StuyCEC/jimbo-0/images/20230901_005157.webp

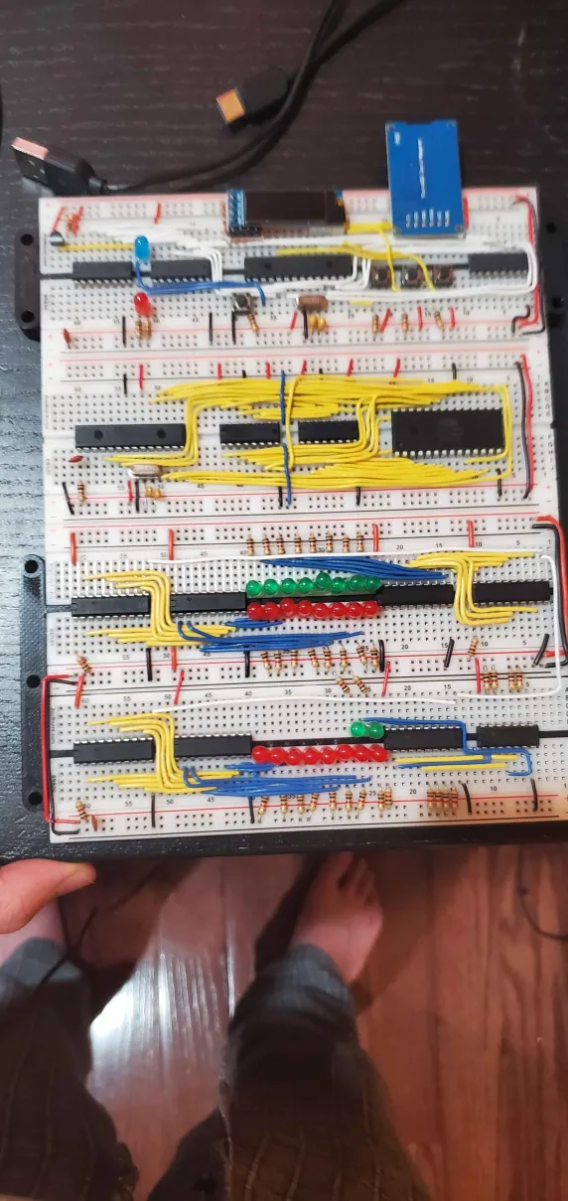
images/20230901_005157.webp
