StuyCEC/jimbo-0/images/20230902_104515.webp

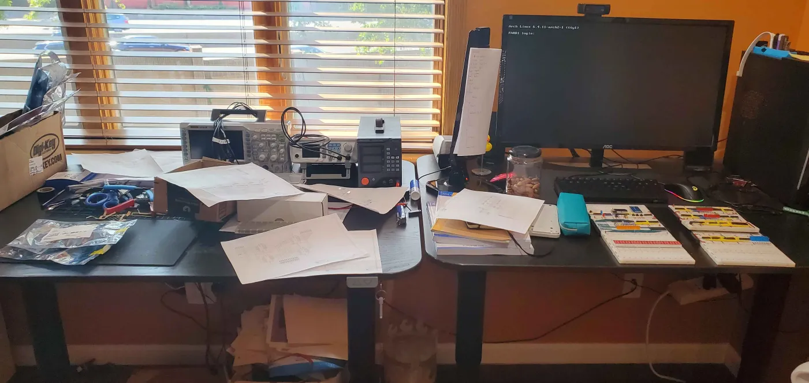
images/20230902_104515.webp
