StuyCEC/jimbo-0/images/20230902_191515.webp

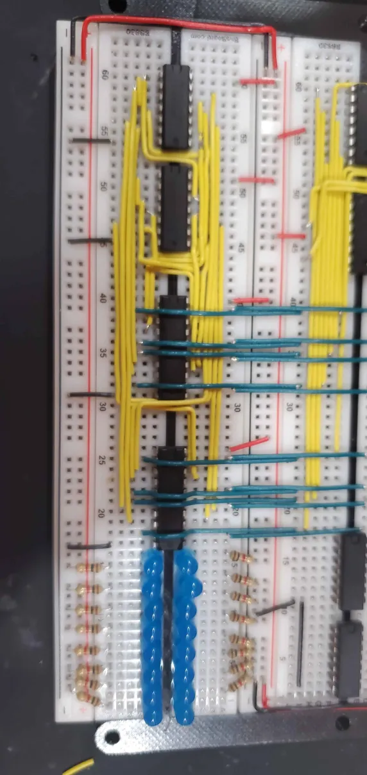
images/20230902_191515.webp
