StuyCEC/jimbo-0/labels/ROM_LABELS.png

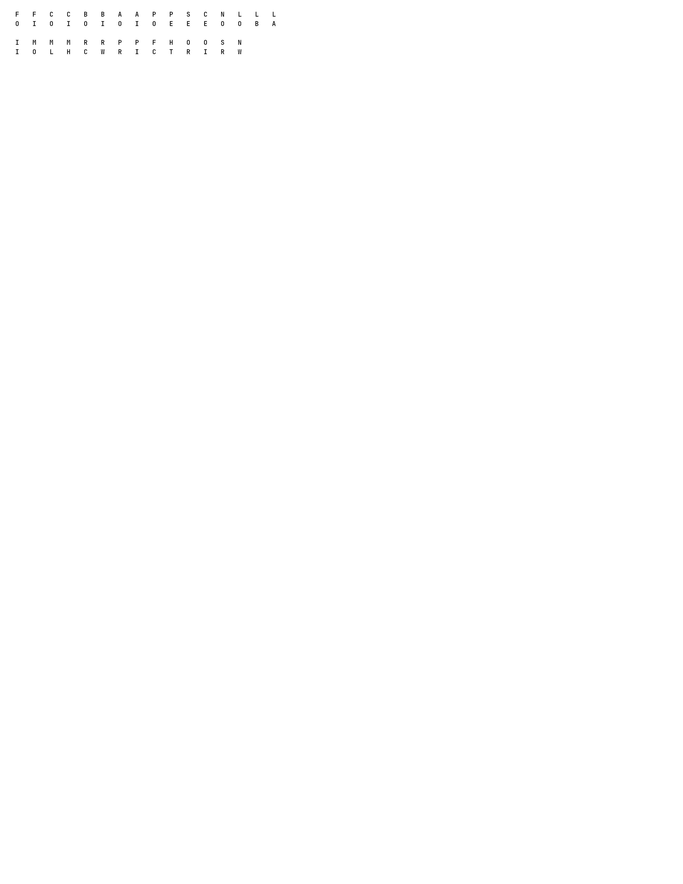
labels/ROM_LABELS.png
