StuyCEC/jimbo-0/schematics/schematics.kicad_pcb

## KiCad design morse_kicad_files/morse_transceiver.kicad_sch

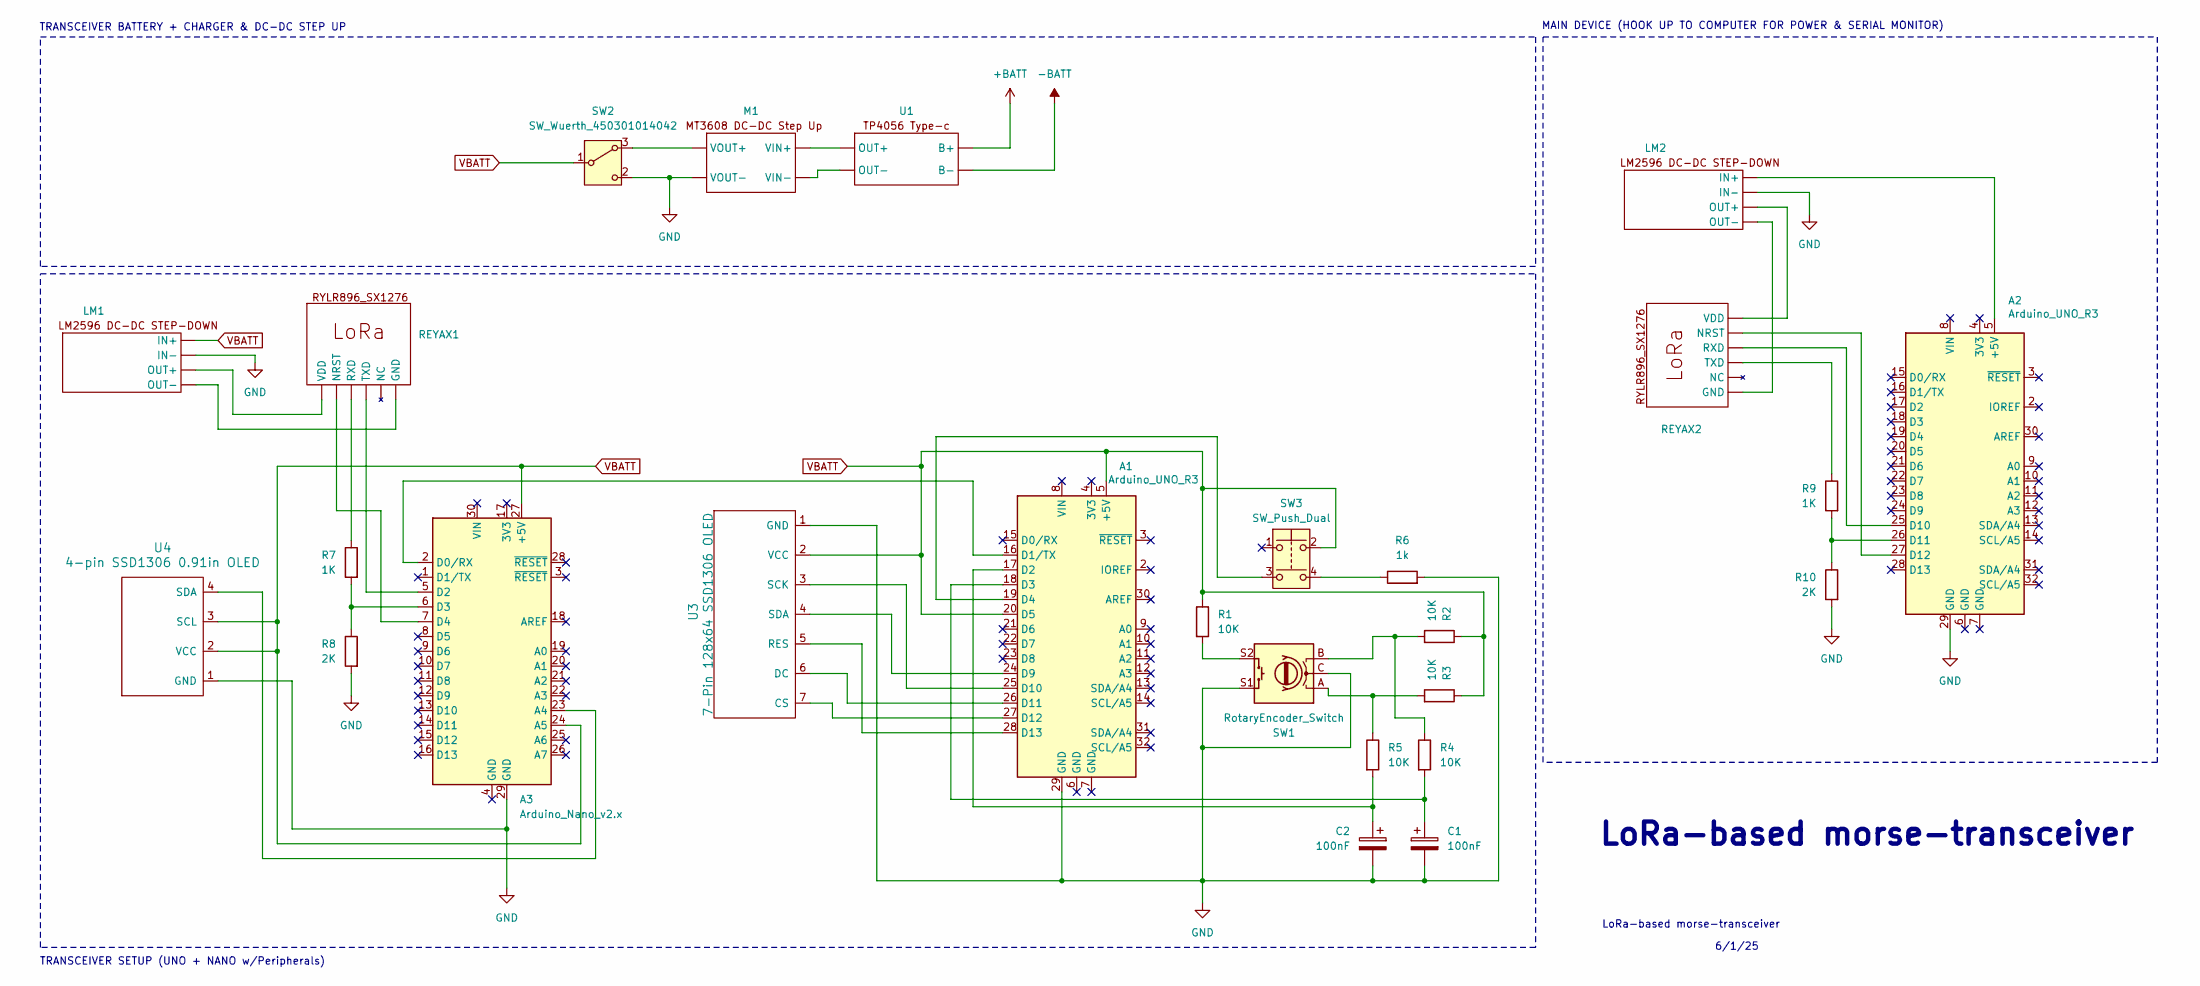
[picture p15: schematic morse_transceiver.kicad_sch]

Parts:
A1, A2: Arduino_UNO_R3
A3: Arduino_Nano_v2.x; Arduino_Nano
C1, C2: 100nF
LM1, LM2: (no value)
M1: (no value)
R1, R2, R3, R4, R5: 10K
R6: 1k
R7, R9: 1K
R8, R10: 2K
REYAX1, REYAX2: (no value)
SW1: RotaryEncoder_Switch
SW2: SW_Wuerth_450301014042; SW_Slide-03_Wuerth-WS-SLTV_10x2.5x6.4_P2.54mm
SW3: SW_Push_Dual
U1: (no value)
U3: 7-Pin 128x64 SSD1306 OLED
U4: 4-pin SSD1306 0.91in OLED

Connections:
+BATT: U1.
-BATT: U1.
GND: A1.29 (GND), A2.29 (GND), A3.29 (GND), C1.2, C2.2, LM1., LM2., M1., R6.2, R8.2, R10.2, SW1.C, SW1.S1, SW2.2 (C), U3.1 (GND), U4.1 (GND)
unnamed: A1.16 (D1/TX), A3.2 (D0/RX)
unnamed: A1.17 (D2), C2.1, R5.2
unnamed: A1.18 (D3), C1.1, R4.2
unnamed: A1.19 (D4), SW3.3
unnamed: A1.24 (D9), U3.4 (SDA)
unnamed: A1.25 (D10), U3.3 (SCK)
unnamed: A1.26 (D11), U3.6 (DC)
unnamed: A1.27 (D12), U3.7 (CS)
unnamed: A1.28 (D13), U3.5 (RES)
unnamed: A2.5 (+5V), LM2.
unnamed: A2.25 (D10), REYAX2.
unnamed: A2.26 (D11), R9.2, R10.1
unnamed: A2.27 (D12), REYAX2.
unnamed: A3.5 (D2), REYAX1.
unnamed: A3.6 (D3), R7.2, R8.1
unnamed: A3.7 (D4), REYAX1.
unnamed: A3.23 (A4), U4.4 (SDA)
unnamed: LM1., REYAX1.
unnamed: LM2., REYAX2.
unnamed: M1., SW2.3 (A), U1.
unnamed: R1.2, SW1.S2
unnamed: R2.2, R4.1, SW1.B
unnamed: R3.2, R5.1, SW1.A
unnamed: R6.1, SW3.4
unnamed: R7.1, REYAX1.
unnamed: R9.1, REYAX2.
VBATT: A1.5 (+5V), A1.20 (D5), A3.24 (A5), A3.27 (+5V), LM1., R1.1, R2.1, R3.1, SW2.1 (B), SW3.2, U3.2 (VCC), U4.2 (VCC), U4.3 (SCL)

Notes on the sheet:
LoRa-based morse-transceiver
TRANSCEIVER SETUP (UNO + NANO w/Peripherals)
MAIN DEVICE (HOOK UP TO COMPUTER FOR POWER & SERIAL MONITOR)
TRANSCEIVER BATTERY + CHARGER & DC-DC STEP UP
6/1/25
