StuyCEC/jimbo-0/arduino-sketches/clock-module/config.h

 //Micro SD
#define SD_CS PB2

//CLOCK PIN
#define CLOCK PD0
#define HLT PD2

//Shift register pins
#define SER PD3
#define SRCLK PD4
#define SRCLR PD5
#define A_RCLK PD6
#define D_RCLK PD1
#define OE PD7

//RAM PINS
#define RAM_WE PC3
#define RAM_CE PC2
#define ROM_OE PC0

//OLED
#define OLED_RESET -1
#define I2C_ADDRESS 0x3C

//INPUT
#define BT1 PB0
#define BT2 PB1
#define BT3 PC1
#define debounceTimeOut 100

//SD CARD
#define SD_CS PB2
