StuyCEC/jimbo-0/arduino-sketches/output-register/config.h

//pins 
//D0 - D7
const byte BUS_PINS[8] = {PB1, PC5, PD0, PD1, PD2, PD5, PD6, PD7};
#define SER PC4
#define SRCLK PB0
#define OUT_IN PD2
#define OUT_CLR PD3

//7 segment pins right to left
const byte SEG_SEL[8] = {PB5, PB4, PB3, PB2, PC3, PC2, PC1, PC0};
