StuyCEC/jimbo-0/output-register/config.h

//pins 
//D0 - D7
const byte BUS_PINS[8] = {9, A5, 0, 1, 4, 5, 6, 7};
#define SER A4
#define SRCLK 8
#define OUT_IN 2
#define OUT_CLR 3

//7 segment pins right to left
const byte SEG_SEL[8] = {13, 12, 11, 10, A3, A2, A1, A0};
