StuyCEC/jimbo-0/(commit log)

2023-08-27 control logic finished
    [ALU.kicad_sch, Con_ROM.kicad_sch, I_Reg.kicad_sch, M Register.kicad_sch, RAM.kicad_sch, schematics.kicad_sch]
2023-09-05 alot of progress
    [Out.kicad_sch, schematics.kicad_sch]
2023-09-24 updated arduino sketches and schematics (RECOVERED FILES)
    [ALU.kicad_sch, A_Reg.kicad_sch, B_Reg.kicad_sch, C_Reg.kicad_sch, Clock.kicad_sch, Con_ROM.kicad_sch, F_Register.kicad_sch, I_Reg.kicad_sch]
